Ivansquark/displinux/dtc_instruction.txt

IDE=arch/riscv/boot/dts/sun20i-d1s-nezha-linux
SRC=$IDE.dts
TMP=$IDE.tmp.dts
DST=$IDE.dtb

cpp -nostdinc -I include -undef -x assembler-with-cpp $SRC > $TMP
dtc -O dtb -b 0 -o $DST $TMP
rm $TMP
