Ivansquark/displinux/LCPI-T113_D1s_F133(303F133D1S3).pdf

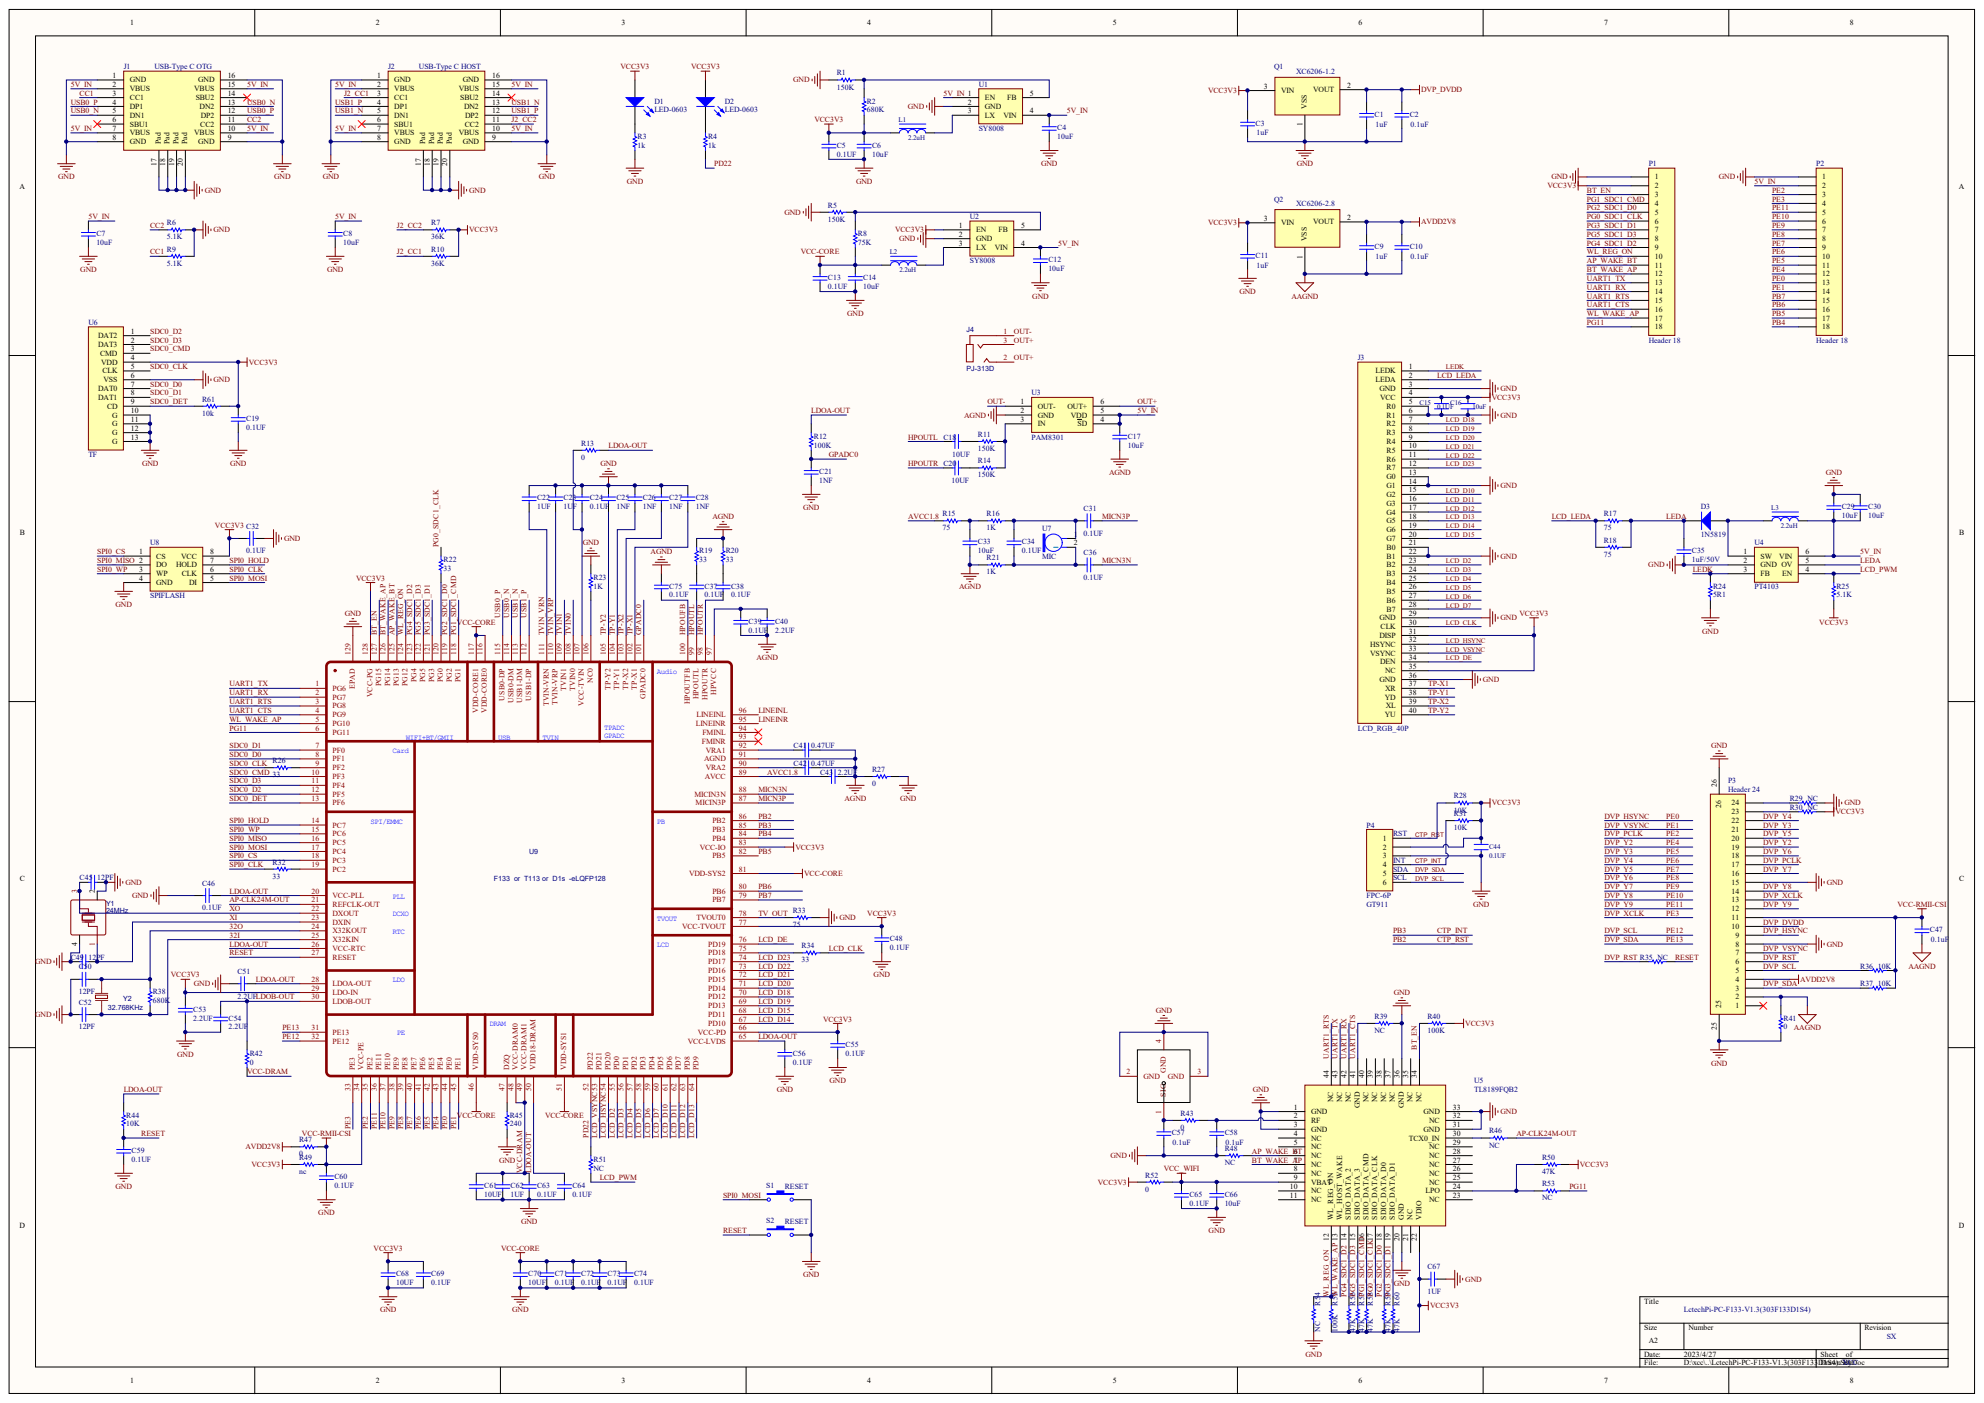
[picture p1: page 1]

INT | CTP_INT

GND | LDO-IN 29
