Ivansquark/displinux/displinux/displinux.kicad_pcb

## KiCad design displinux/displinux.kicad_pcb (2024-12-24)

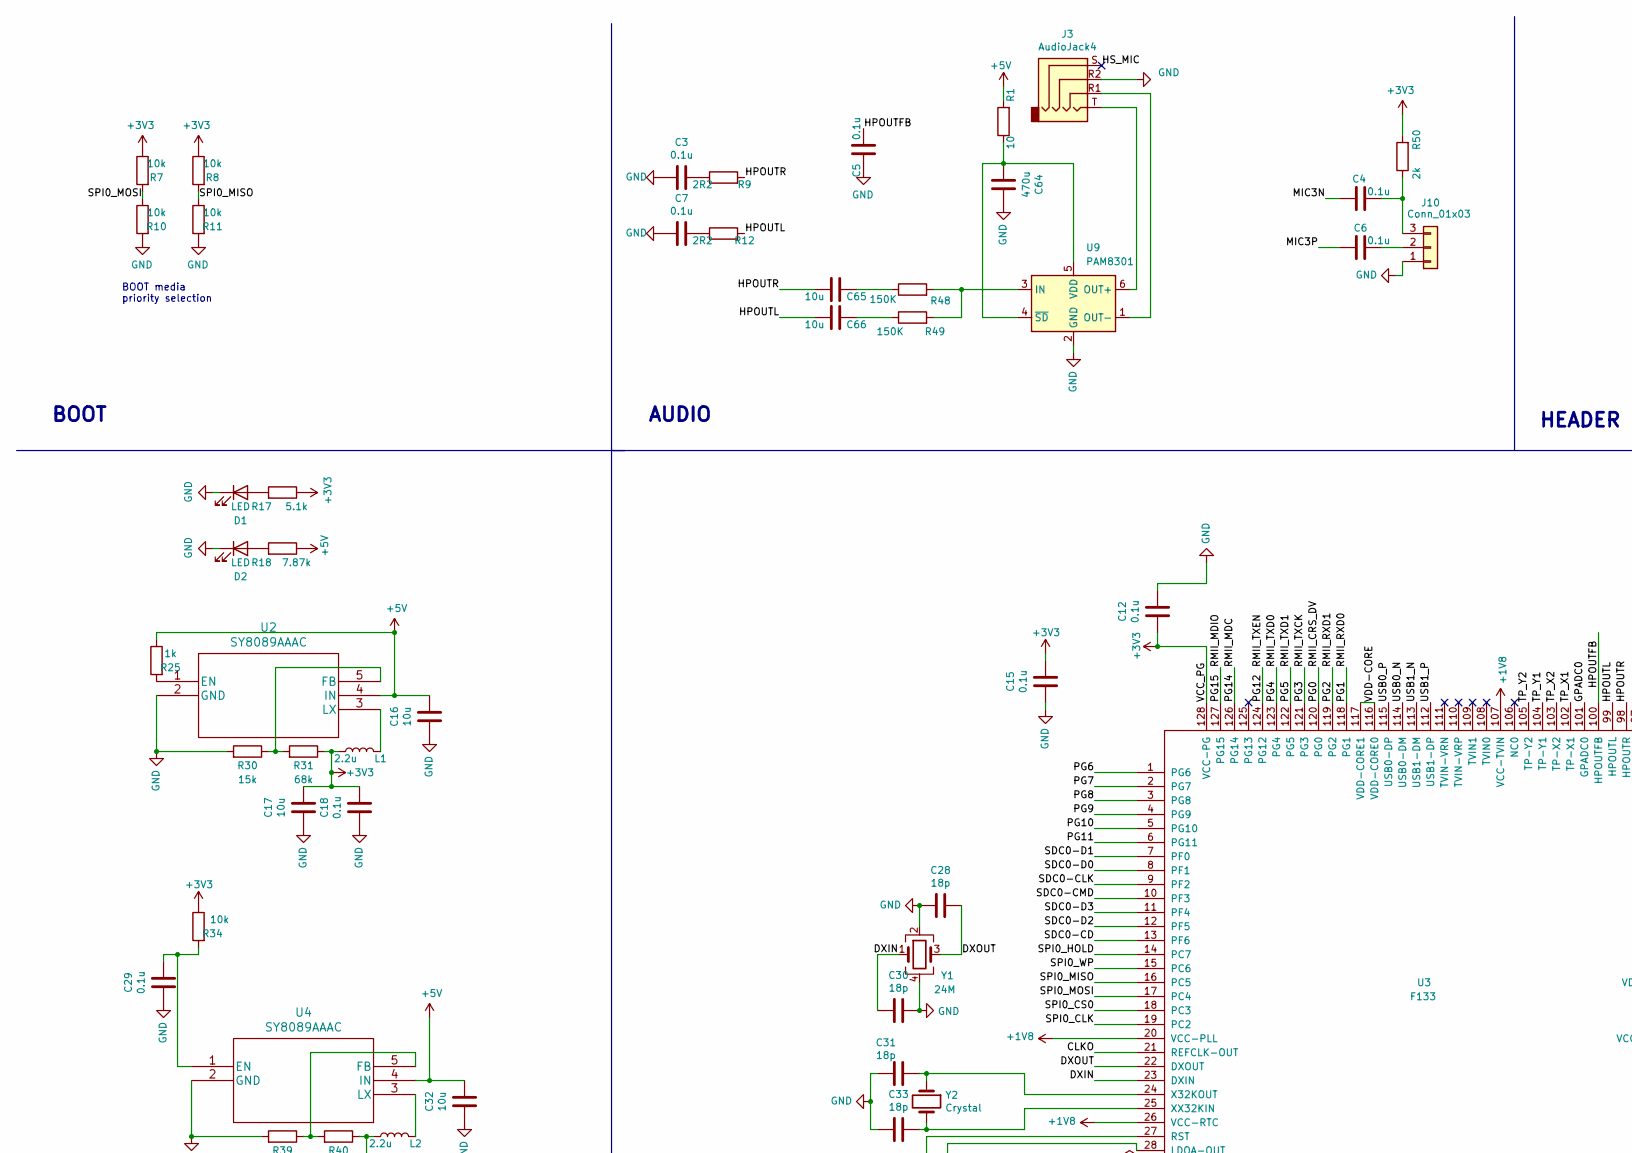
[picture p2: schematic displinux.kicad_sch, part in row 1, column 1]

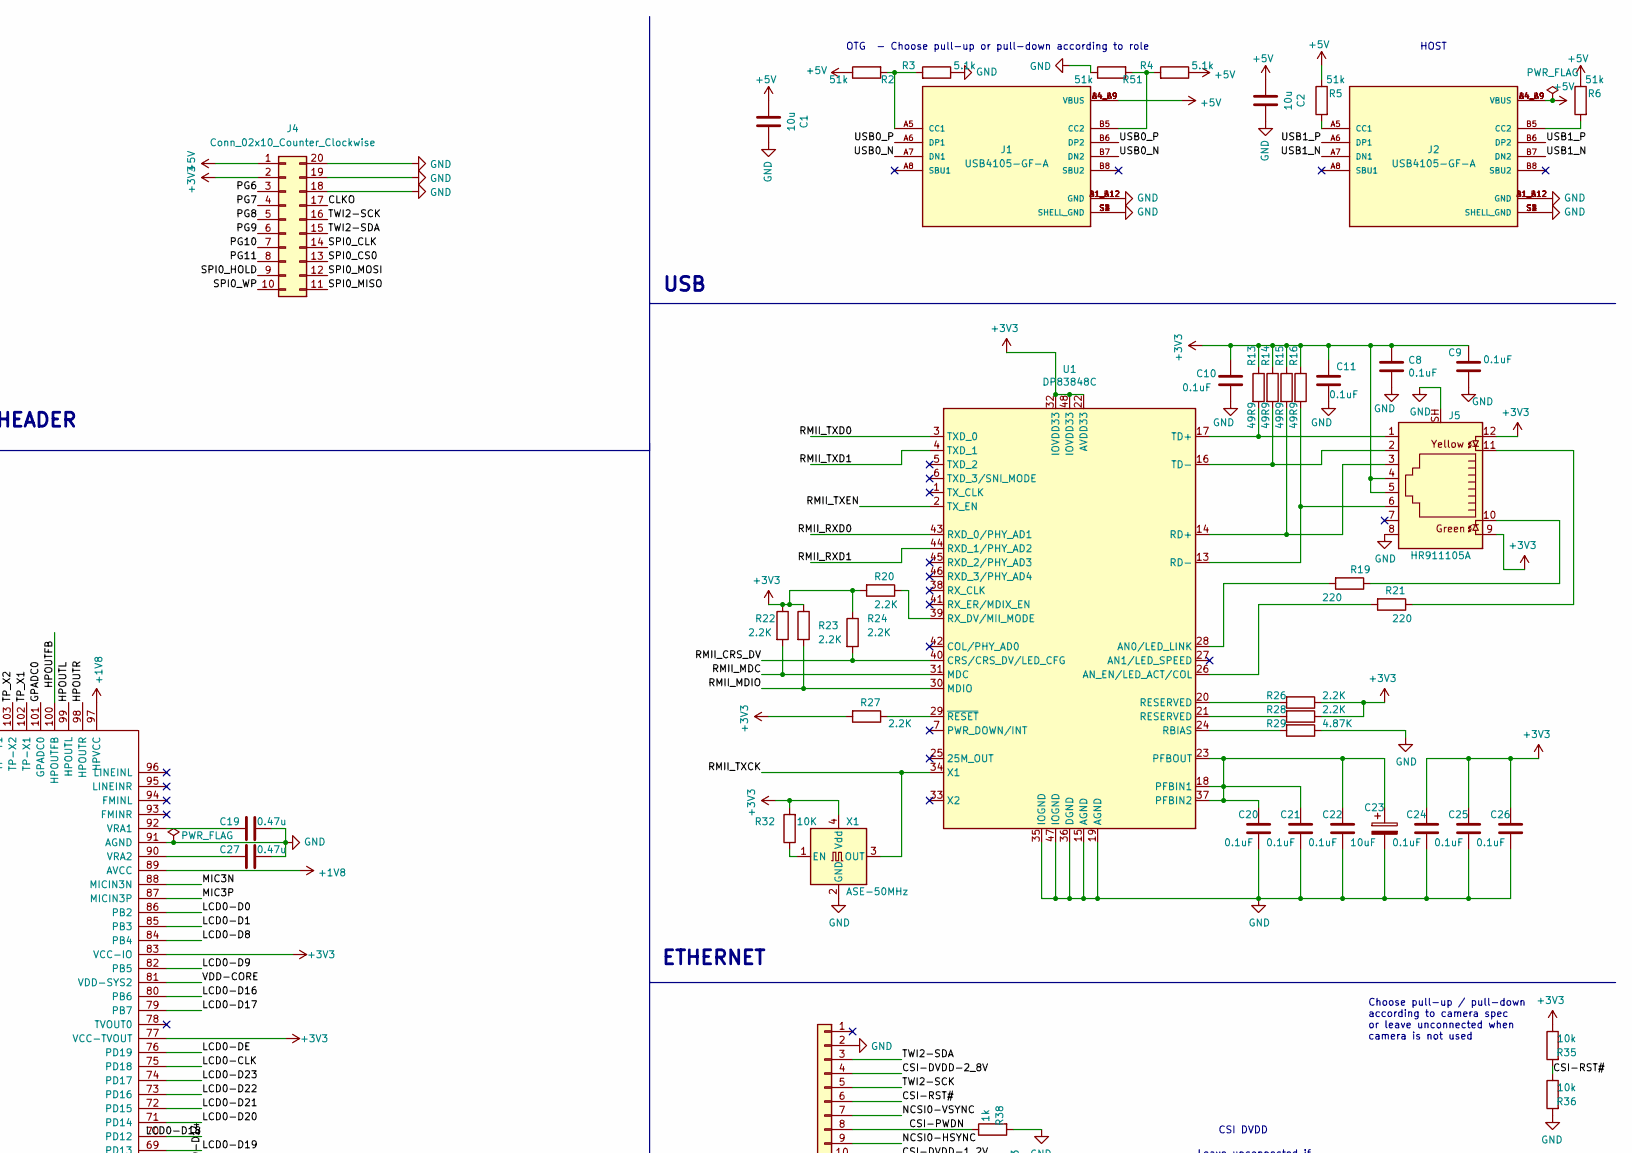
[picture p3: schematic displinux.kicad_sch, part in row 1, column 2]

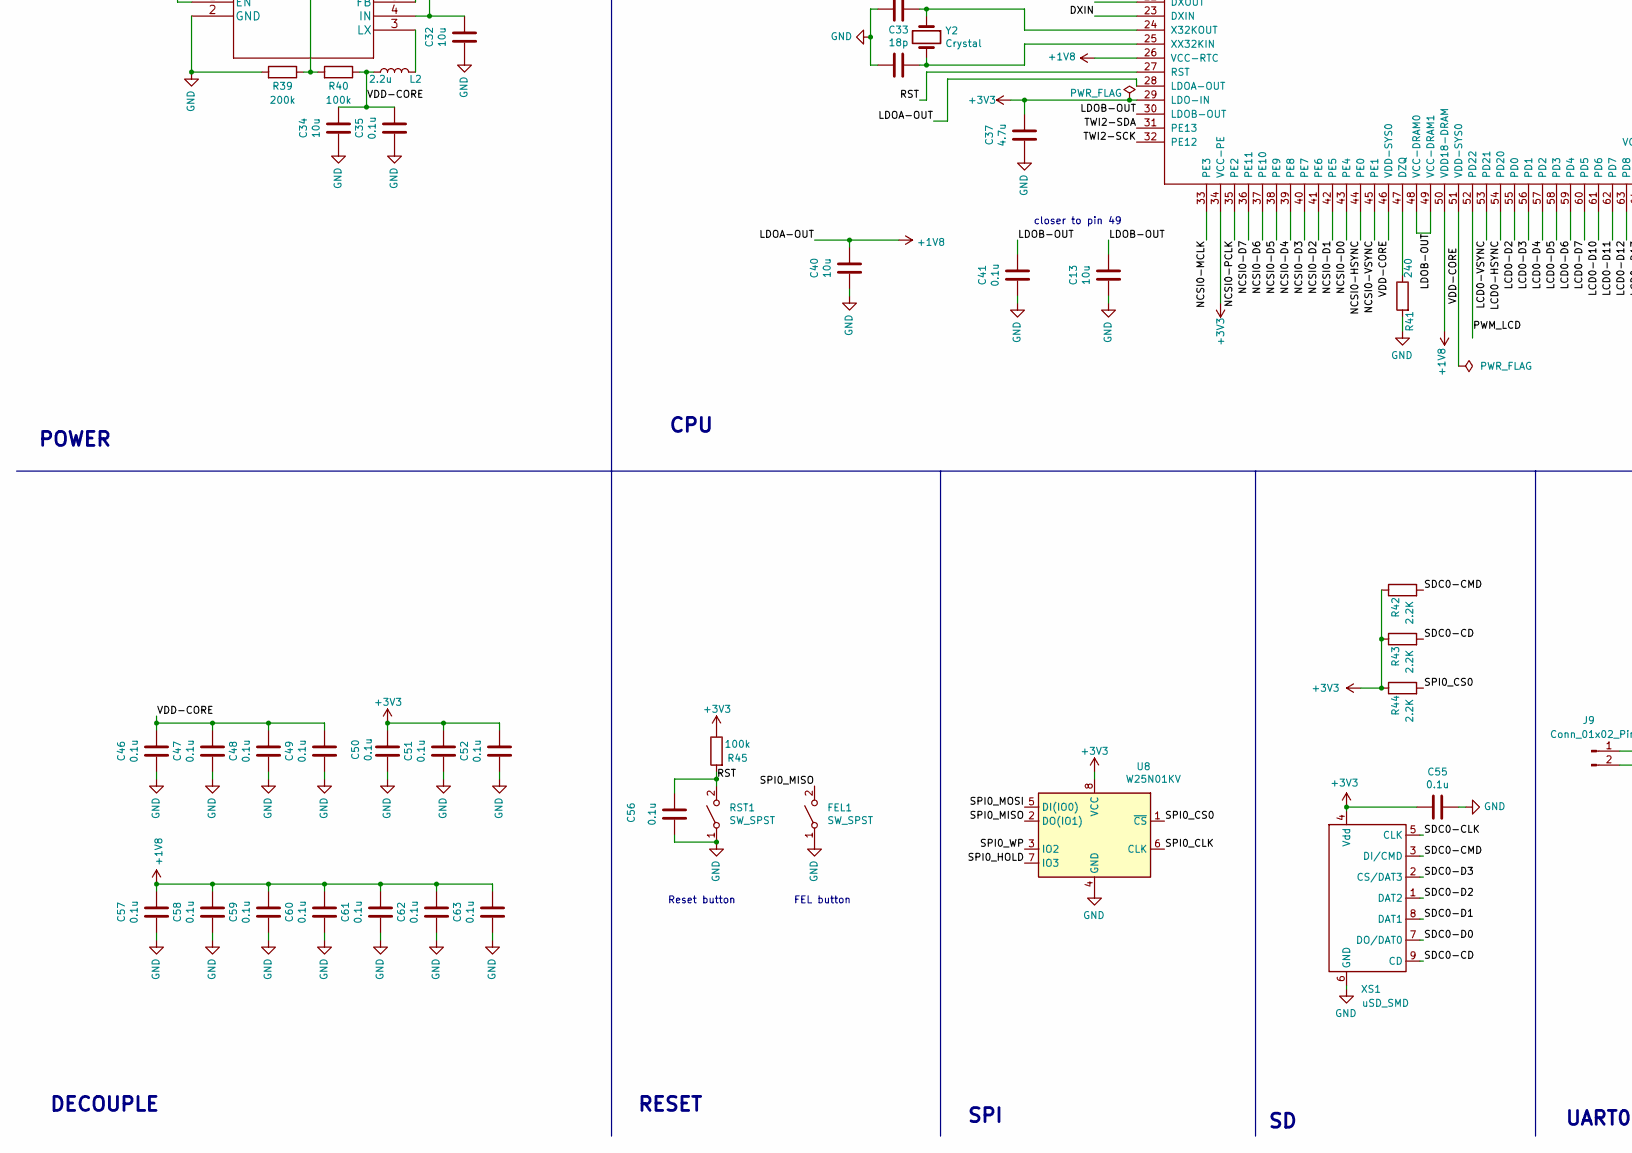
[picture p4: schematic displinux.kicad_sch, part in row 2, column 1]

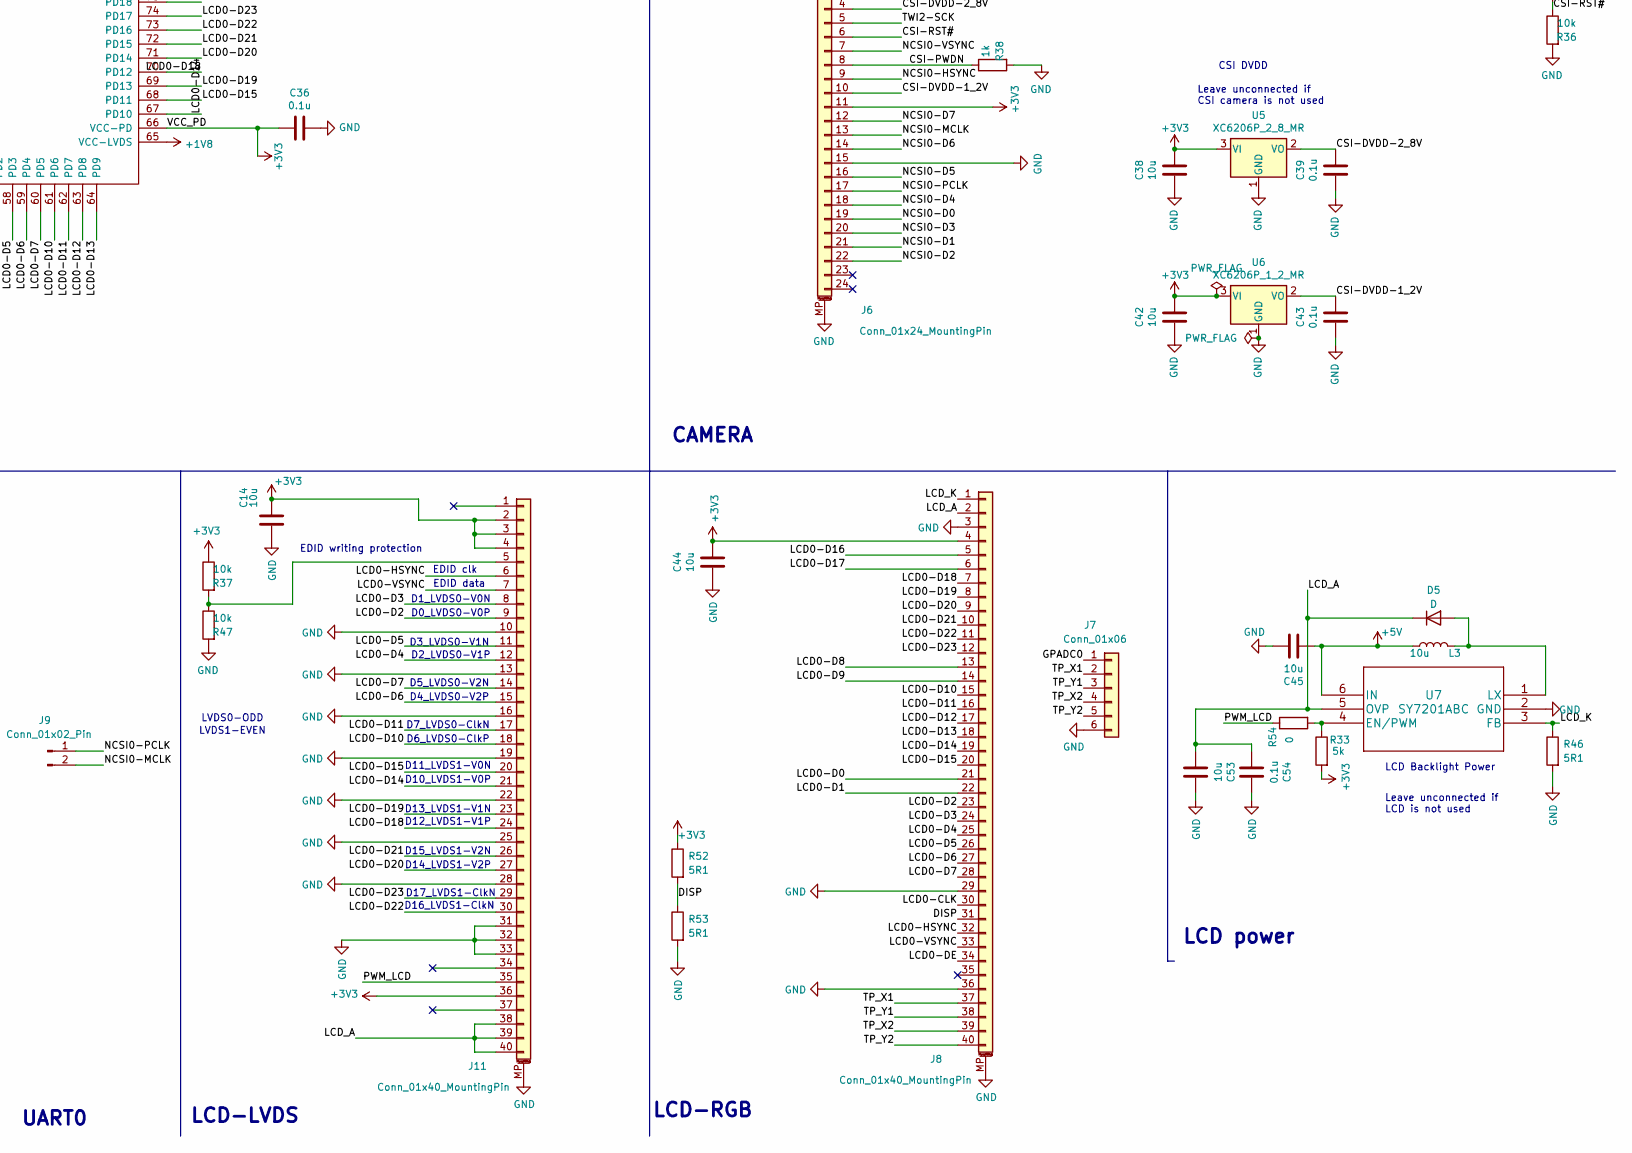
[picture p5: schematic displinux.kicad_sch, part in row 2, column 2]

Parts:
C1, C2, C13, C14, C16, C17, C32, C34, C38, C40, C42, C44, C45, C53, C65, C66: 10u; C_0603_1608Metric
C3, C4, C5, C6, C7, C12, C15, C18, C29, C35, C36, C39, C41, C43, C46, C47, C48, C49, C50, C51, C52, C54, C55, C56, C57, C58, C59, C60, C61, C62, C63: 0.1u; C_0603_1608Metric
C8, C9, C10, C11, C20, C21, C22, C24, C25, C26: 0.1uF; C_0603_1608Metric
C19, C27: 0.47u; C_0603_1608Metric
C23: 10uF; CP_EIA-3216-10_Kemet-I
C28, C30, C31, C33: 18p; C_0603_1608Metric
C37: 4.7u; C_0603_1608Metric
C64: 470u; C_0603_1608Metric
D1, D2: LED; LED_0603_1608Metric
D5: D; D_2010_5025Metric
FEL1: SW_SPST; SW_SPST_EVQPE1
J1, J2: USB4105-GF-A; USB_C_Receptacle_G-Switch_GT-USB-7010ASV; PARTREV A3
J3: AudioJack4; Jack_3.5mm_PJ320D_Horizontal
J4: Conn_02x10_Counter_Clockwise; PinHeader_2x10_P2.54mm_Vertical
J5: HR911105A; RJ45_Hanrun_HR911105A_Horizontal
J6: Conn_01x24_MountingPin; TE_2-1734839-4_1x24-1MP_P0.5mm_Horizontal
J7: Conn_01x06; PinHeader_1x06_P2.54mm_Vertical
J8, J11: Conn_01x40_MountingPin; TE_4-1734839-0_1x40-1MP_P0.5mm_Horizontal
J9: Conn_01x02_Pin; PinHeader_1x02_P2.54mm_Vertical
J10: Conn_01x03; PinHeader_1x03_P2.54mm_Vertical
L1, L2: 2.2u; L_Wurth_WE-LQSH-3012
L3: 10u; L_Wurth_WE-LQSH-3012
R1: 10; R_0603_1608Metric
R2, R5, R6, R51: 51k; R_0603_1608Metric
R3, R4, R17: 5.1k; R_0603_1608Metric
R7, R8, R10, R11, R34, R35, R36, R37, R47: 10k; R_0603_1608Metric
R9, R12: 2R2; R_0603_1608Metric
R13, R14, R15, R16: 49R9; R_0603_1608Metric
R18: 7.87k; R_0603_1608Metric
R19, R21: 220; R_0603_1608Metric
R20, R22, R23, R24, R26, R27, R28, R42, R43, R44: 2.2K; R_0603_1608Metric
R25, R38: 1k; R_0603_1608Metric
R29: 4.87K; R_0805_2012Metric_Pad1.20x1.40mm_HandSolder
R30: 15k; R_0603_1608Metric
R31: 68k; R_0603_1608Metric
R32: 10K; R_0603_1608Metric
R33: 5k; R_0603_1608Metric
R39: 200k; R_0603_1608Metric
R40, R45: 100k; R_0603_1608Metric
R41: 240; R_0603_1608Metric
R46, R52, R53: 5R1; R_0603_1608Metric
R48, R49: 150K; R_0603_1608Metric
R50: 2k; R_0603_1608Metric
R54: 0; R_0603_1608Metric
RST1: SW_SPST; SW_SPST_EVQPE1
U1: DP83848C; LQFP-48_7x7mm_P0.5mm
U2, U4: SY8089AAAC; SOT-23-5
U3: F133; LQFP-128_14x14mm_P0.4mm
U5: XC6206P_2_8_MR; SOT-23
U6: XC6206P_1_2_MR; SOT-23
U7: SY7201ABC; SOT-23-6
U8: W25N01KV; WSON-8-1EP_6x5mm_P1.27mm_EP3.4x4.3mm
U9: PAM8301; SOT-23-6
X1: ASE-50MHz; Oscillator_SMD_Abracon_ASE-4Pin_3.2x2.5mm
XS1: uSD_SMD; J_SD_Card-micro_socket_A
Y1: 24M; Crystal_SMD_3225-4Pin_3.2x2.5mm
Y2: Crystal; Crystal_SMD_3215-2Pin_3.2x1.5mm

Connections:
+1V8: C40.1, C57.1, C58.1, C59.1, C60.1, C61.1, C62.1, C63.1, U3.20 (VCC-PLL), U3.26 (VCC-RTC), U3.28 (LDOA-OUT), U3.50 (VDD18-DRAM), U3.65 (VCC-LVDS), U3.89 (AVCC), U3.97 (HPVCC), U3.107 (VCC-TVIN)
+3V3: C8.1, C9.1, C10.1, C11.1, C12.2, C14.1, C15.1, C17.1, C18.1, C24.1, C25.1, C26.1, C36.2, C37.1, C38.2, C42.2, C44.1, C50.1, C51.1, C52.1, C55.1, J4.2, J5.4, J5.5, J5.9, J5.12, J6.11, J8.4, J11.2, J11.3, J11.4, J11.36, L1.1, R7.1, R8.1, R13.1, R14.1, R15.1, R16.1, R17.1, R20.2, R22.1, R23.1, R24.1, R26.1, R27.2, R28.1, R31.1, R32.2, R33.2, R34.1, R35.1, R37.1, R42.1, R43.1, R44.1, R45.1, R50.2, R52.1, U1.22 (AVDD33), U1.32 (IOVDD33), U1.48 (IOVDD33), U3.29 (LDO-IN), U3.34 (VCC-PE), U3.66 (VCC-PD), U3.77 (VCC-TVOUT), U3.83 (VCC-IO), U3.128 (VCC-PG), U5.3 (VI), U6.3 (VI), U8.8 (VCC), X1.4 (Vdd), XS1.4 (Vdd)
+5V: C1.1, C2.1, C16.1, C32.1, C45.1, J1.A4_B9 (VBUS), J1.B4_A9 (VBUS), J2.A4_B9 (VBUS), J2.B4_A9 (VBUS), J4.1, L3.1, R1.2, R2.1, R4.1, R5.1, R6.1, R18.1, R25.1, U2.4 (IN), U4.4 (IN), U7.6 (IN)
/CLKO: J4.17, U3.21 (REFCLK-OUT)
/CSI-DVDD-1_2V: C43.1, J6.10, U6.2 (VO)
/CSI-DVDD-2_8V: C39.1, J6.4, U5.2 (VO)
/CSI-PWDN: J6.8, R38.1
/CSI-RST#: J6.6, R35.2, R36.1
/DISP: J8.31, R52.2, R53.1
/DXIN: C30.2, U3.23 (DXIN), Y1.1
/DXOUT: C28.1, U3.22 (DXOUT), Y1.3
/GPADC0: J7.1, U3.101 (GPADC0)
/HPOUTFB: C5.1, U3.100 (HPOUTFB)
/HPOUTL: C66.1, R12.2, U3.99 (HPOUTL)
/HPOUTR: C65.1, R9.2, U3.98 (HPOUTR)
/HS_MIC: J3.S
/LCD0-CLK: J8.30, U3.75 (PD18)
/LCD0-D0: J8.21, U3.86 (PB2)
/LCD0-D1: J8.22, U3.85 (PB3)
/LCD0-D2: J8.23, J11.9, U3.55 (PD0)
/LCD0-D3: J8.24, J11.8, U3.56 (PD1)
/LCD0-D4: J8.25, J11.12, U3.57 (PD2)
/LCD0-D5: J8.26, J11.11, U3.58 (PD3)
/LCD0-D6: J8.27, J11.15, U3.59 (PD4)
/LCD0-D7: J8.28, J11.14, U3.60 (PD5)
/LCD0-D8: J8.13, U3.84 (PB4)
/LCD0-D9: J8.14, U3.82 (PB5)
/LCD0-D10: J8.15, J11.18, U3.61 (PD6)
/LCD0-D11: J8.16, J11.17, U3.62 (PD7)
/LCD0-D12: J8.17, U3.63 (PD8)
/LCD0-D13: J8.18, U3.64 (PD9)
/LCD0-D14: J8.19, J11.21, U3.67 (PD10)
/LCD0-D15: J8.20, J11.20, U3.68 (PD11)
/LCD0-D16: J8.5, U3.80 (PB6)
/LCD0-D17: J8.6, U3.79 (PB7)
/LCD0-D18: J8.7, J11.24, U3.70 (PD12)
/LCD0-D19: J8.8, J11.23, U3.69 (PD13)
/LCD0-D20: J8.9, J11.27, U3.71 (PD14)
/LCD0-D21: J8.10, J11.26, U3.72 (PD15)
/LCD0-D22: J8.11, J11.30, U3.73 (PD16)
/LCD0-D23: J8.12, J11.29, U3.74 (PD17)
/LCD0-DE: J8.34, U3.76 (PD19)
/LCD0-HSYNC: J8.32, J11.6, U3.54 (PD20)
/LCD0-VSYNC: J8.33, J11.7, U3.53 (PD21)
/LCD_A: C53.1, C54.1, D5.1 (K), J8.2, J11.38, J11.39, J11.40, U7.5 (OVP)
/LCD_K: J8.1, R46.1, U7.3 (FB)
/LDOB-OUT: C13.1, C41.1, U3.30 (LDOB-OUT), U3.48 (VCC-DRAM0), U3.49 (VCC-DRAM1)
/MIC3N: C4.1, U3.88 (MICIN3N)
/MIC3P: C6.1, U3.87 (MICIN3P)
/NCSI0-D0: J6.19, U3.43 (PE4)
/NCSI0-D1: J6.21, U3.42 (PE5)
/NCSI0-D2: J6.22, U3.41 (PE6)
/NCSI0-D3: J6.20, U3.40 (PE7)
/NCSI0-D4: J6.18, U3.39 (PE8)
/NCSI0-D5: J6.16, U3.38 (PE9)
/NCSI0-D6: J6.14, U3.37 (PE10)
/NCSI0-D7: J6.12, U3.36 (PE11)
/NCSI0-HSYNC: J6.9, U3.44 (PE0)
/NCSI0-MCLK: J6.13, J9.2, U3.33 (PE3)
/NCSI0-PCLK: J6.17, J9.1, U3.35 (PE2)
/NCSI0-VSYNC: J6.7, U3.45 (PE1)
/PG0: R24.2, U1.40 (CRS/CRS_DV/LED_CFG), U3.120 (PG0)
/PG1: U1.43 (RXD_0/PHY_AD1), U3.118 (PG1)
/PG2: U1.44 (RXD_1/PHY_AD2), U3.119 (PG2)
/PG3: U1.34 (X1), U3.121 (PG3), X1.3 (OUT)
/PG4: U1.3 (TXD_0), U3.123 (PG4)
/PG5: U1.4 (TXD_1), U3.122 (PG5)
/PG6: J4.3, U3.1 (PG6)
/PG7: J4.4, U3.2 (PG7)
/PG8: J4.5, U3.3 (PG8)
/PG9: J4.6, U3.4 (PG9)
/PG10: J4.7, U3.5 (PG10)
/PG11: J4.8, U3.6 (PG11)
/PG12: U1.2 (TX_EN), U3.124 (PG12)
/PG14: R22.2, U1.31 (MDC), U3.126 (PG14)
/PG15: R23.2, U1.30 (MDIO), U3.127 (PG15)
/PWM_LCD: J11.35, R54.1, U3.52 (PD22)
/RST: C56.1, R45.2, RST1.2 (B), U3.27 (RST)
/SDC0-CD: R43.2, U3.13 (PF6), XS1.9 (CD)
/SDC0-CLK: U3.9 (PF2), XS1.5 (CLK)
/SDC0-CMD: R42.2, U3.10 (PF3), XS1.3 (DI/CMD)
/SDC0-D0: U3.8 (PF1), XS1.7 (DO/DAT0)
/SDC0-D1: U3.7 (PF0), XS1.8 (DAT1)
/SDC0-D2: U3.12 (PF5), XS1.1 (DAT2)
/SDC0-D3: U3.11 (PF4), XS1.2 (CS/DAT3)
/SPI0_CLK: J4.14, U3.19 (PC2), U8.6 (CLK)
/SPI0_CS0: J4.13, R44.2, U3.18 (PC3), U8.1 (~CS)
/SPI0_HOLD: J4.9, U3.14 (PC7), U8.7 (IO3)
/SPI0_MISO: FEL1.2 (B), J4.11, R8.2, R11.1, U3.16 (PC5), U8.2 (DO(IO1))
/SPI0_MOSI: J4.12, R7.2, R10.1, U3.17 (PC4), U8.5 (DI(IO0))
/SPI0_WP: J4.10, U3.15 (PC6), U8.3 (IO2)
/TP_X1: J7.2, J8.37, U3.102 (TP-X1)
/TP_X2: J7.4, J8.39, U3.103 (TP-X2)
/TP_Y1: J7.3, J8.38, U3.104 (TP-Y1)
/TP_Y2: J7.5, J8.40, U3.105 (TP-Y2)
/TWI2-SCK: J4.16, J6.5, U3.32 (PE12)
/TWI2-SDA: J4.15, J6.3, U3.31 (PE13)
/USB0_N: J1.A7 (DN1), J1.B7 (DN2), U3.114 (USB0-DM)
/USB0_P: J1.A6 (DP1), J1.B6 (DP2), U3.115 (USB0-DP)
/USB1_N: J2.A7 (DN1), J2.B7 (DN2), U3.113 (USB1-DM)
/USB1_P: J2.A6 (DP1), J2.B6 (DP2), U3.112 (USB1-DP)
/VDD-CORE: C34.1, C35.1, C46.1, C47.1, C48.1, C49.1, L2.1, R40.1, U3.46 (VDD-SYS0), U3.51 (VDD-SYS0), U3.81 (VDD-SYS2), U3.116 (VDD-CORE0), U3.117 (VDD-CORE1)
GND: C1.2, C2.2, C3.1, C5.2, C7.1, C8.2, C9.2, C10.2, C11.2, C12.1, C13.2, C14.2, C15.2, C16.2, C17.2, C18.2, C19.1, C20.2, C21.2, C22.2, C23.2, C24.2, C25.2, C26.2, C27.1, C28.2, C29.2, C30.1, C31.2, C32.2, C33.2, C34.2, C35.2, C36.1, C37.2, C38.1, C39.2, C40.2, C41.2, C42.1, C43.2, C44.2, C45.2, C46.2, C47.2, C48.2, C49.2, C50.2, C51.2, C52.2, C53.2, C54.2, C55.2, C56.2, C57.2, C58.2, C59.2, C60.2, C61.2, C62.2, C63.2, C64.2, D1.1 (K), D2.1 (K), FEL1.1 (A), J1.A1_B12 (GND), J1.B1_A12 (GND), J1.S1 (SHELL_GND), J1.S2 (SHELL_GND), J1.S3 (SHELL_GND), J1.S4 (SHELL_GND), J2.A1_B12 (GND), J2.B1_A12 (GND), J2.S1 (SHELL_GND), J2.S2 (SHELL_GND), J2.S3 (SHELL_GND), J2.S4 (SHELL_GND), J3.R2, J4.18, J4.19, J4.20, J5.8, J5.SH, J6.2, J6.15, J6.MP (MountPin), J7.6, J8.3, J8.29, J8.36, J8.MP (MountPin), J10.1, J11.10, J11.13, J11.16, J11.19, J11.22, J11.25, J11.28, J11.31, J11.32, J11.33, J11.MP (MountPin), R3.1, R10.2, R11.2, R29.1, R30.2, R36.2, R38.2, R39.2, R41.2, R46.2, R47.2, R51.1, R53.2, RST1.1 (A), U1.15 (AGND), U1.19 (AGND), U1.35 (IOGND), U1.36 (DGND), U1.47 (IOGND), U2.2 (GND), U3.91 (AGND), U4.2 (GND), U5.1 (GND), U6.1 (GND), U7.2 (GND), U8.4 (GND), U9.2 (GND), X1.2 (GND), XS1.6 (GND), XS1.SH, Y1.2, Y1.4
unnamed: C3.2, R9.1
unnamed: C7.2, R12.1
unnamed: C65.2, R48.1
unnamed: C66.2, R49.1
unnamed: D1.2 (A), R17.2
unnamed: D2.2 (A), R18.2
unnamed: D5.2 (A), L3.2, U7.1 (LX)
unnamed: J1.A5 (CC1), R2.2, R3.2
unnamed: J1.B5 (CC2), R4.2, R51.2
unnamed: J2.A5 (CC1), R5.2
unnamed: J2.B5 (CC2), R6.2
unnamed: J5.10, R19.1
unnamed: J5.11, R21.1
unnamed: C6.2, J10.2
unnamed: C4.2, J10.3, R50.1
unnamed: J11.5, R37.2, R47.1
unnamed: R26.2, U1.20 (RESERVED)
unnamed: R28.2, U1.21 (RESERVED)
unnamed: R19.2, U1.28 (AN0/LED_LINK)
unnamed: R21.2, U1.26 (AN_EN/LED_ACT/COL)
unnamed: C20.1, C21.1, C22.1, C23.1, U1.18 (PFBIN1), U1.23 (PFBOUT), U1.37 (PFBIN2)
unnamed: R29.2, U1.24 (RBIAS)
unnamed: J5.3, R15.2, U1.14 (RD+)
unnamed: J5.6, R16.2, U1.13 (RD-)
unnamed: R20.1, U1.39 (RX_DV/MII_MODE)
unnamed: J5.1, R13.2, U1.17 (TD+)
unnamed: J5.2, R14.2, U1.16 (TD-)
unnamed: R27.1, U1.29 (~RESET)
unnamed: R25.2, U2.1 (EN)
unnamed: R30.1, R31.2, U2.5 (FB)
unnamed: L1.2, U2.3 (LX)
unnamed: R41.1, U3.47 (DZQ)
unnamed: C19.2, U3.92 (VRA1)
unnamed: C27.2, U3.90 (VRA2)
unnamed: C31.1, U3.24 (X32KOUT), Y2.1
unnamed: C33.1, U3.25 (XX32KIN), Y2.2
unnamed: C29.1, R34.2, U4.1 (EN)
unnamed: R39.1, R40.2, U4.5 (FB)
unnamed: L2.2, U4.3 (LX)
unnamed: R33.1, R54.2, U7.4 (EN/PWM)
unnamed: R48.2, R49.2, U9.3 (IN)
unnamed: J3.T, U9.6 (OUT+)
unnamed: J3.R1, U9.1 (OUT-)
unnamed: C64.1, R1.1, U9.4 (~SD), U9.5 (VDD)
unnamed: R32.1, X1.1 (EN)

Notes on the sheet:
USB
BOOT
SPI
D10_LVDS1-V0P
closer to pin 49
LVDS1-EVEN
D11_LVDS1-V0N
D1_LVDS0-V0N
HOST
D4_LVDS0-V2P
CAMERA
D0_LVDS0-V0P
EDID clk
D3_LVDS0-V1N
D17_LVDS1-ClkN
D5_LVDS0-V2N
Choose pull-up / pull-down according to camera spec or leave unconnected when camera is not used
Leave unconnected if LCD is not used
D2_LVDS0-V1P
D13_LVDS1-V1N
D12_LVDS1-V1P
CSI DVDD
D15_LVDS1-V2N
D6_LVDS0-ClkP
DECOUPLE
LCD-LVDS
EDID writing protection
UART0
BOOT media priority selection
HEADER
POWER
LCD-RGB
FEL button
D16_LVDS1-ClkN
D14_LVDS1-V2P
D7_LVDS0-ClkN
OTG - Choose pull-up or pull-down according to role
EDID data
LCD power
LCD Backlight Power
CPU
RESET
ETHERNET
Reset button
LVDS0-ODD
AUDIO
Leave unconnected if CSI camera is not used

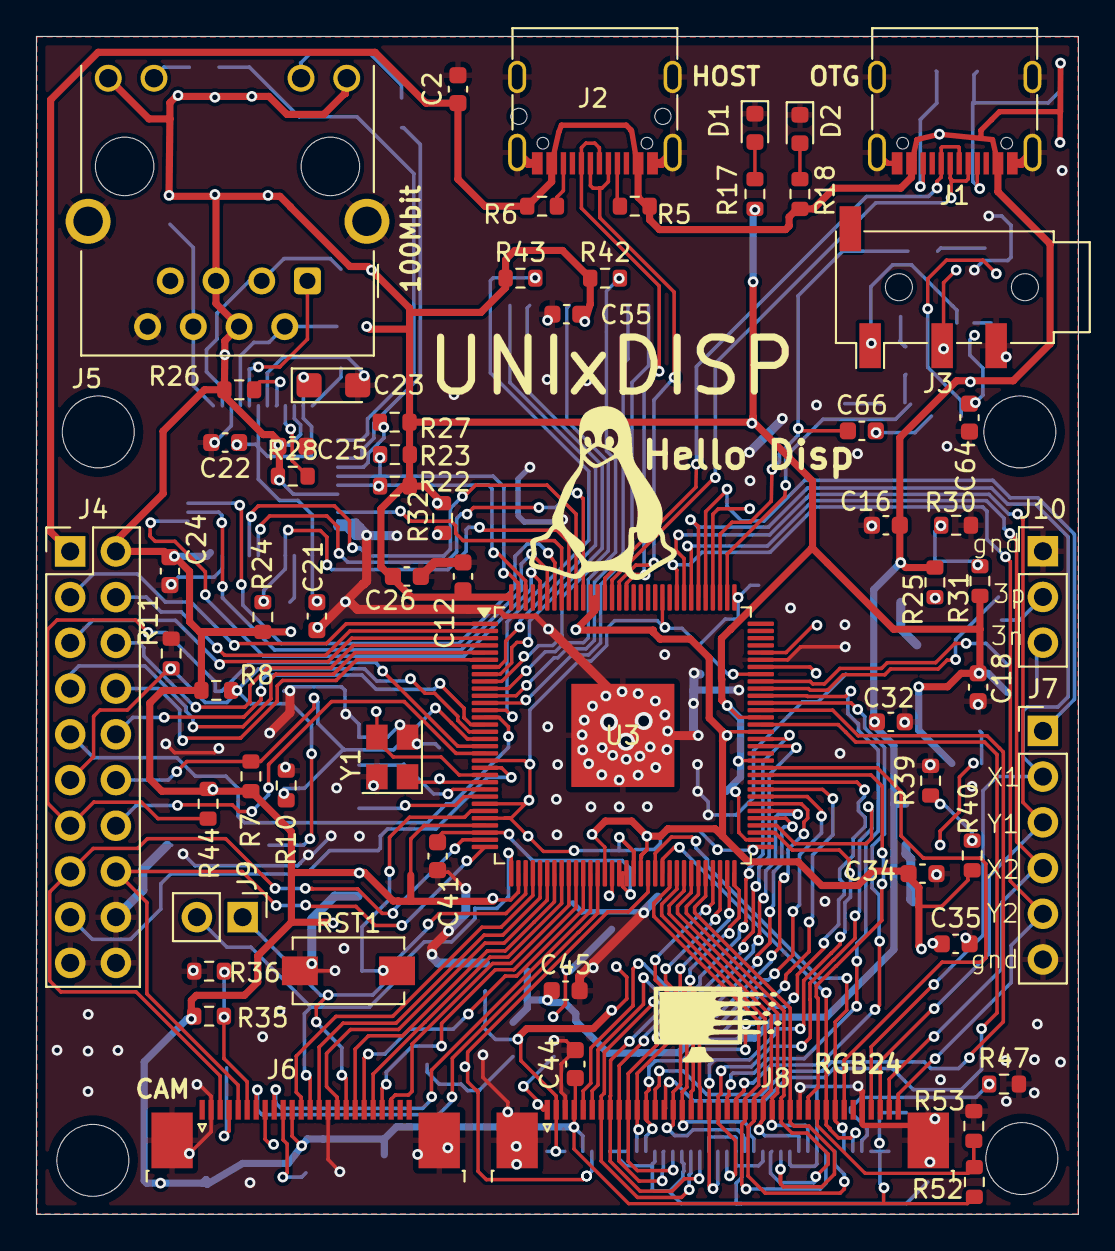
[picture p6: board displinux.kicad_pcb from above]

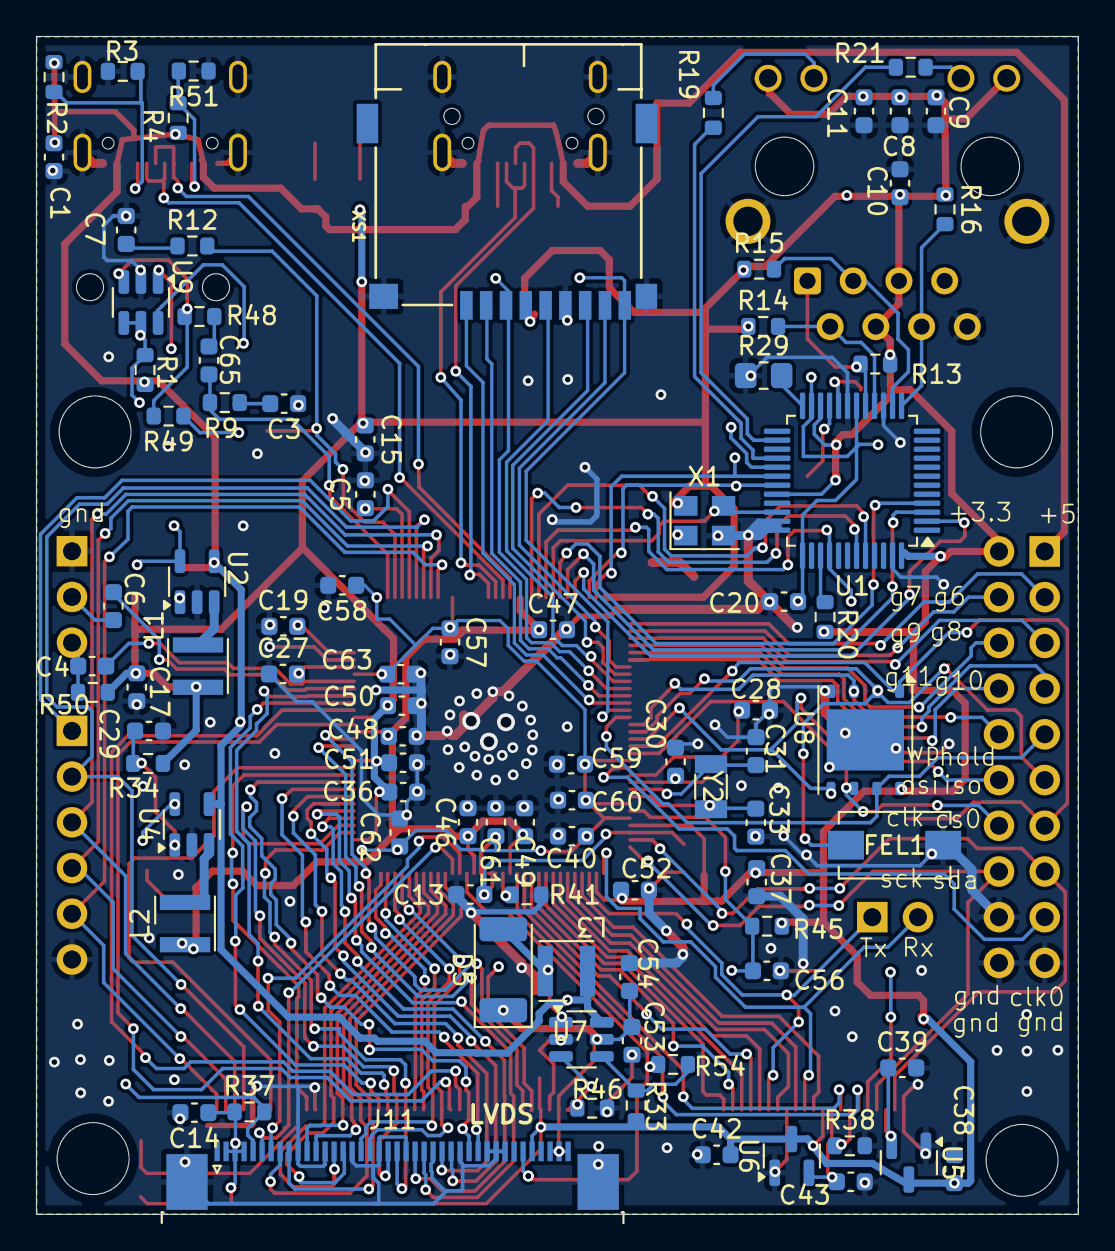
[picture p7: board displinux.kicad_pcb from below]

Board: 2 copper layers, 57.9 x 65.4 mm, 153 parts (90 on the bottom side), 147 nets.

Other parts of the board:
Hello Disp: LOGO; linux_mascot
