Ivansquark/displinux/example/Xassette-Asterisk/hw/XassetteAsterisk.kicad_pcb

## KiCad design example/Xassette-Asterisk/hw/XassetteAsterisk.kicad_pcb (2024-07-05)

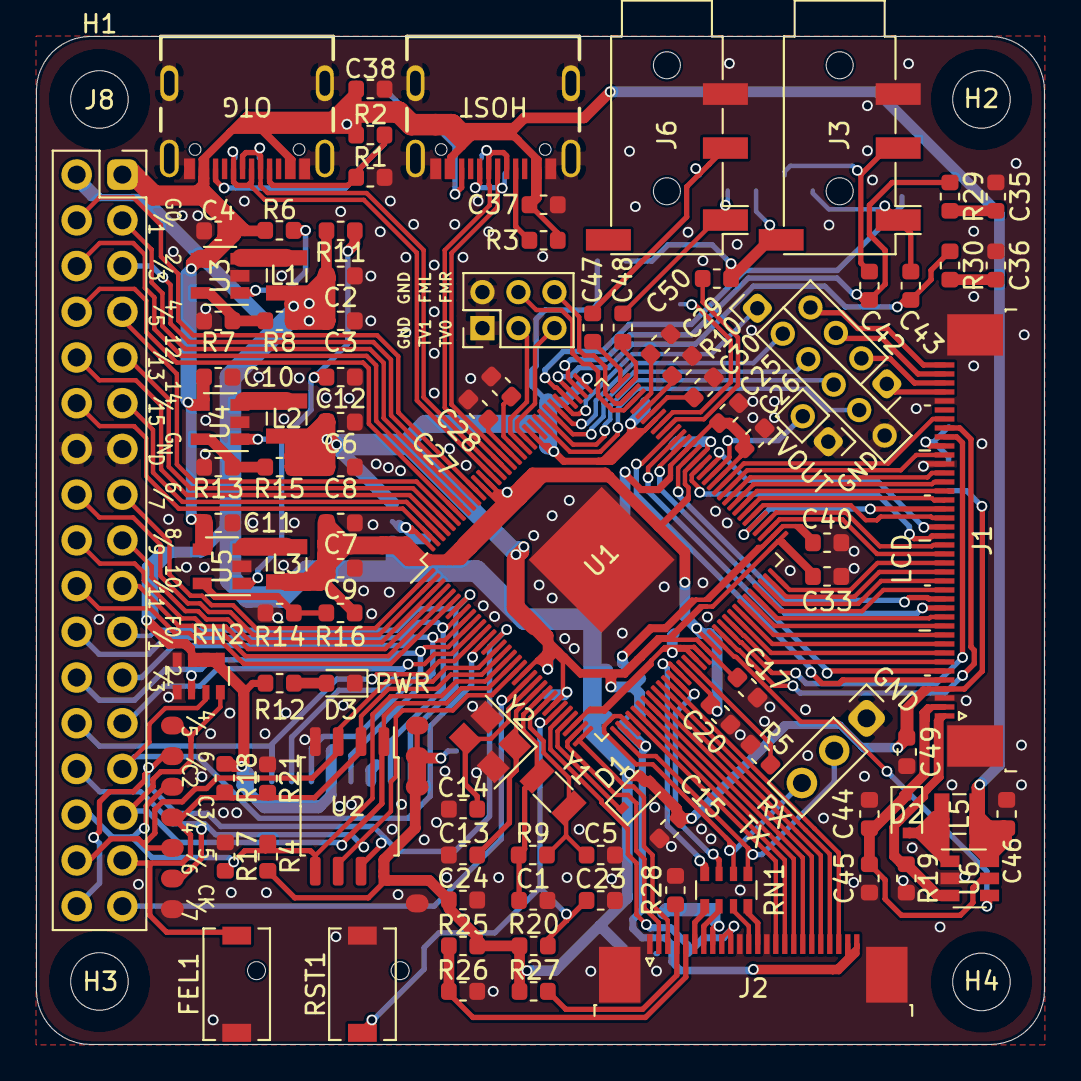
[picture p9: board XassetteAsterisk.kicad_pcb from above]

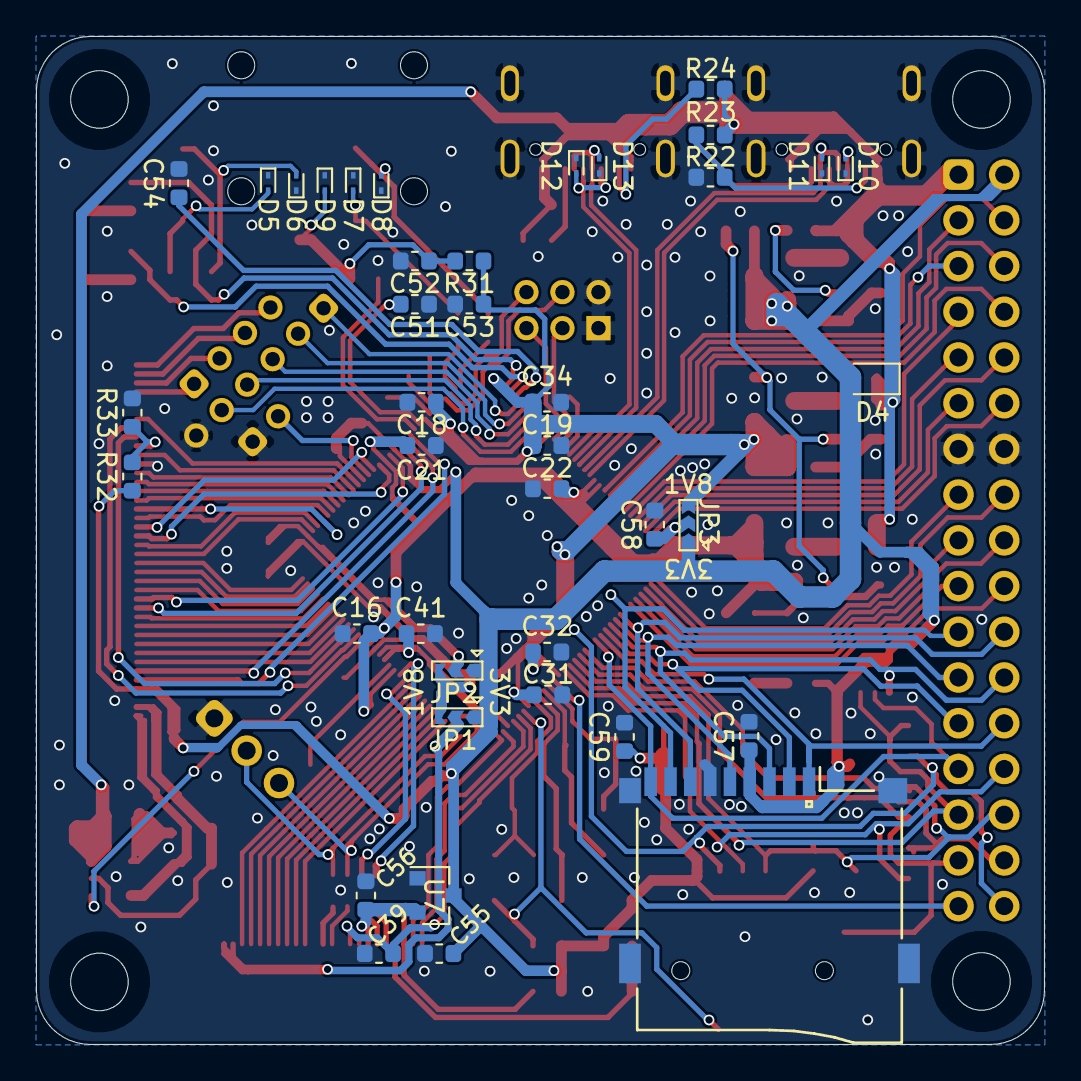
[picture p10: board XassetteAsterisk.kicad_pcb from below]

Board: 2 copper layers, 56.0 x 56.0 mm, 145 parts (41 on the bottom side), 151 nets.

Parts:
C1, C5, C13, C14: 18p; C_0603_1608Metric
C2, C4, C6, C7, C10, C11, C37, C38, C44, C46, C53, C55: 10u; C_0603_1608Metric
C3, C8, C9, C12, C15, C16, C17, C18, C19, C20, C21, C22, C23, C24, C25, C26, C31, C32, C33, C34, C35, C36, C39, C40, C41, C42, C43, C45, C47, C48, C49, C50, C51, C54, C56, C57, C58, C59: 0.1u; C_0603_1608Metric
C27, C28: 1u; C_0603_1608Metric
C29, C30: 0.47u; C_0603_1608Metric
C52: 33p; C_0603_1608Metric
D1, D2, D4: D; D_SOD-323
D3: LED; LED_0603_1608Metric
D5, D6, D7, D8, D9, D10, D11, D12, D13: ESD9B3.3ST5G; D_SOD-923
FEL1: SW_SPST; SW_SPST_EVQPE1
H1, H2, H3, H4: MountingHole; MountingHole_3.2mm_M3
H5: MountingHole_Pad; SolderWirePad_1x01_SMD_5x10mm
J1: Conn_01x40_MountingPin; TE_4-1734839-0_1x40-1MP_P0.5mm_Horizontal
J2: Conn_01x24_MountingPin; TE_2-1734839-4_1x24-1MP_P0.5mm_Horizontal
J3, J6: AudioJack4; Jack_3.5mm_PJ320D_Horizontal
J4, J5: USB4105-GF-A; GCT_USB4105-GF-A
J7: Conn_01x04; PinSocket_1x04_P2.00mm_Vertical
J8: Conn_02x17_Odd_Even; PinSocket_2x17_P2.54mm_Vertical
J9: Conn_01x06; PinHeader_1x06_P2.00mm_Vertical
J10: Conn_02x03_Odd_Even; PinHeader_2x03_P2.00mm_Vertical
J11: Conn_01x02; PinHeader_1x02_P2.00mm_Vertical
J12: Conn_01x03; PinHeader_1x03_P2.54mm_Vertical
J13: RTL8189FTV_Mod; 8189Mod
JP1, JP2, JP3: Jumper_3_Open; SolderJumper-3_P2.0mm_Open_TrianglePad1.0x1.5mm
L1, L2, L3: 2.2u; L_Wuerth_MAPI-2510
L5: 10u; L_Wuerth_MAPI-2510
R1, R2, R3, R12, R22, R23, R24: 5.1k; R_0603_1608Metric
R4, R11, R17, R18, R21, R25, R26, R27, R28, R32, R33: 10k; R_0603_1608Metric
R5: 240; R_0603_1608Metric
R6: 1k; R_0603_1608Metric
R7: 15k; R_0603_1608Metric
R8: 68k; R_0603_1608Metric
R9: 10M; R_0603_1608Metric
R10: 0; R_0603_1608Metric
R13, R16, R20: 100k; R_0603_1608Metric
R14, R15: 200k; R_0603_1608Metric
R19, R29, R30: 2R2; R_0603_1608Metric
R31: 2.2k; R_0603_1608Metric
RN1, RN2: R_Pack04; R_Array_Convex_4x0603
RST1: SW_SPST; SW_SPST_EVQPE1
Ref**: Val**; rvlogo_inv
U1: F133; LQFP-128_14x14mm_P0.4mm
U2: W25Q32JVSS; SOIC-8_5.23x5.23mm_P1.27mm
U3, U4, U5: SY8089AAAC; SOT-23-5
U6: SY7201ABC; SOT-23-6
U7: XC6206PxxxMR; SOT-23
XS1: uSD_SMD; Conn_uSDcard
Y1: Crystal; Crystal_SMD_3215-2Pin_3.2x1.5mm
Y2: 24M; Crystal_SMD_3225-4Pin_3.2x2.5mm

Connections:
+1V8: C6.1, C8.1, C17.1, C18.1, C19.1, C31.1, C32.1, C33.1, C34.1, C53.1, JP1.3, JP2.3, JP3.3, L2.1, R15.1, R31.1, U1.20, U1.26, U1.50, U1.65, U1.89, U1.97, U1.107
+3V3: C2.1, C3.1, C15.1, C24.1, C25.1, C26.1, C49.1, C55.2, C57.1, C59.1, D1.2, D4.2, J1.4, J8.2, J13.11, J13.12, J13.13, JP1.1, JP2.1, JP3.1, L1.1, R4.1, R8.1, R11.1, R12.1, R18.1, R20.1, R25.1, R27.1, R32.1, RN2.1, RN2.2, RN2.3, U1.77, U1.83, U2.8, U7.3, XS1.4
+5V: C4.1, C10.1, C11.1, C37.1, C38.1, C46.1, D4.1, J4.A4_B9, J4.B4_A9, J5.A4_B9, J5.B4_A9, J8.1, L5.1, R2.1, R3.1, R6.1, R23.1, R24.1, U3.4, U4.4, U5.4, U6.6
/CLKO: J8.33, U1.21
/CSI-AVDD: C39.1, J2.9, J2.10, U1.28
/CSI-DVDD: C56.1, J2.8, U7.2
/CSI-IOVDD: J2.23, J2.24, JP1.2, U1.34
/CSI-PWDN: J2.5, R25.2, R26.1
/CSI-RST#: J2.4, R27.2, R28.1
/DISP: J1.31, R32.2, R33.1
/DXIN: C13.2, U1.23, Y2.1
/DXOUT: C14.1, U1.22, Y2.3
/FMINL: J10.6, U1.94
/FMINR: J10.4, U1.93
/GPADC0: J9.1, U1.101
/HPOUTFB: C54.1, U1.100
/HPOUTL: C43.2, R30.2, U1.99
/HPOUTR: C42.2, R29.2, U1.98
/HS_MIC: C50.2, C52.1, D9.2, J3.S, R31.2
/LCD0-CLK: J1.30, U1.75
/LCD0-D0: J1.5, U1.86
/LCD0-D1: J1.6, U1.85
/LCD0-D2: J1.7, U1.55
/LCD0-D3: J1.8, U1.56
/LCD0-D4: J1.9, U1.57
/LCD0-D5: J1.10, U1.58
/LCD0-D6: J1.11, U1.59
/LCD0-D7: J1.12, U1.60
/LCD0-D8: J1.13, U1.84
/LCD0-D9: J1.14, U1.82
/LCD0-D10: J1.15, U1.61
/LCD0-D11: J1.16, U1.62
/LCD0-D12: J1.17, U1.63
/LCD0-D13: J1.18, U1.64
/LCD0-D14: J1.19, U1.67
/LCD0-D15: J1.20, U1.68
/LCD0-D16: J1.21, U1.80
/LCD0-D17: J1.22, U1.79
/LCD0-D18: J1.23, U1.70
/LCD0-D19: J1.24, U1.69
/LCD0-D20: J1.25, U1.71
/LCD0-D21: J1.26, U1.72
/LCD0-D22: J1.27, U1.73
/LCD0-D23: J1.28, U1.74
/LCD0-DE: J1.34, U1.76
/LCD0-HSYNC: J1.32, U1.54
/LCD0-VSYNC: J1.33, U1.53
/LCD0_PWM: U1.52, U6.4
/LCD_A: C44.1, C45.1, D2.1, J1.2, U6.5
/LCD_K: J1.1, R19.1, U6.3
/LDOB-OUT: C41.1, U1.30, U1.48, U1.49
/LINEL: C47.2, U1.96
/LINER: C48.2, U1.95
/MIC3N: C51.1, U1.88
/MIC3P: C50.1, U1.87
/NCSI0-D0: J2.22, U1.43
/NCSI0-D1: J2.21, U1.42
/NCSI0-D2: J2.20, U1.41
/NCSI0-D3: J2.19, U1.40
/NCSI0-D4: J2.18, U1.39
/NCSI0-D5: J2.17, U1.38
/NCSI0-D6: J2.16, U1.37
/NCSI0-D7: J2.15, U1.36
/NCSI0-HSYNC: RN1.7, U1.44
/NCSI0-MCLK: J12.2, RN1.5, U1.33
/NCSI0-PCLK: J12.3, RN1.6, U1.35
/NCSI0-VSYNC: RN1.8, U1.45
/PC2: J8.28, J13.6, U1.19, U2.6
/PC3: J8.29, J13.1, RN2.8, U1.18, U2.1
/PC4: J8.30, J13.3, R4.2, R17.1, U1.17, U2.5
/PC5: FEL1.2, J8.31, J13.4, R18.2, R21.1, U1.16, U2.2
/PC6: J8.32, J13.5, U1.15, U2.3
/PC7: J8.34, J13.2, U1.14, U2.7
/PF0: J8.21, U1.7, XS1.8
/PF1: J8.22, U1.8, XS1.7
/PF2: J8.23, U1.9, XS1.5
/PF3: J8.24, RN2.6, U1.10, XS1.3
/PF4: J8.25, U1.11, XS1.2
/PF5: J8.26, U1.12, XS1.1
/PF6: J8.27, RN2.7, U1.13, XS1.9
/PG0: J8.3, U1.120
/PG1: J8.4, U1.118
/PG2: J8.5, U1.119
/PG3: J8.6, U1.121
/PG4: J8.7, U1.123
/PG5: J8.8, U1.122
/PG6: J8.15, U1.1
/PG7: J8.16, U1.2
/PG8: J8.17, U1.3
/PG9: J8.18, U1.4
/PG10: J8.19, U1.5
/PG11: J8.20, U1.6
/PG12: J8.9, U1.124
/PG13: J8.10, U1.125
/PG14: J8.11, U1.126
/PG15: J8.12, U1.127
/RST: C23.1, R20.2, RST1.2, U1.27
/TP_X1: J9.2, U1.102
/TP_X2: J9.3, U1.103
/TP_Y1: J9.4, U1.104
/TP_Y2: J9.5, U1.105
/TVIN0: J10.5, U1.108
/TVIN1: J10.3, U1.109
/TVOUT: J11.2, U1.78
/TWI2-SCK: J2.3, U1.32
/TWI2-SDA: J2.2, U1.31
/USB0_N: D11.2, J4.A7, J4.B7, U1.114
/USB0_P: D10.2, J4.A6, J4.B6, U1.115
/USB1_N: D13.2, J5.A7, J5.B7, U1.113
/USB1_P: D12.2, J5.A6, J5.B6, U1.112
/VCC_PD: C40.2, JP2.2, U1.66
/VCC_PG: C58.2, JP3.2, U1.128
/VDD-CORE: C7.1, C9.1, C16.1, C20.1, C21.1, C22.1, L3.1, R16.1, U1.46, U1.51, U1.81, U1.116, U1.117
GND: C1.2, C2.2, C3.2, C4.2, C5.2, C6.2, C7.2, C8.2, C9.2, C10.2, C11.2, C12.2, C13.1, C14.2, C15.2, C16.2, C17.2, C18.2, C19.2, C20.2, C21.2, C22.2, C23.2, C24.2, C25.2, C26.2, C27.2, C28.2, C29.1, C30.1, C31.2, C32.2, C33.2, C34.2, C35.1, C36.1, C37.2, C38.2, C39.2, C40.1, C41.2, C44.2, C45.2, C46.2, C49.2, C51.2, C52.2, C53.2, C54.2, C55.1, C56.2, C57.2, C58.1, C59.2, D3.1, D5.1, D6.1, D7.1, D8.1, D9.1, D10.1, D11.1, D12.1, D13.1, FEL1.1, H5.1, J1.3, J1.29, J1.36, J1.MP, J2.1, J2.11, J2.14, J2.MP, J3.R2, J4.A1_B12, J4.B1_A12, J4.S1, J4.S2, J4.S3, J4.S4, J5.A1_B12, J5.B1_A12, J5.S1, J5.S2, J5.S3, J5.S4, J6.R2, J8.13, J8.14, J9.6, J10.1, J10.2, J11.1, J12.1, J13.7, J13.8, R1.2, R5.2, R7.2, R10.1, R13.2, R14.2, R17.2, R19.2, R21.2, R22.2, R26.2, R28.2, R33.2, RN2.4, RN2.5, RST1.1, U2.4, U3.2, U4.2, U5.2, U6.2, U7.1, XS1.6, Y2.2, Y2.4
unnamed: C1.1, R9.1, U1.24, Y1.1
unnamed: C5.1, R9.2, U1.25, Y1.2
unnamed: C12.1, R11.2, U4.1, U5.1
unnamed: C27.1, U1.111
unnamed: C28.1, U1.110
unnamed: C29.2, U1.92
unnamed: C30.2, U1.90
unnamed: C35.2, R29.1
unnamed: C36.2, R30.1
unnamed: C42.1, D6.2, J3.R1
unnamed: C43.1, D5.2, J3.T
unnamed: C47.1, D8.2, J6.R1
unnamed: C48.1, D7.2, J6.T
unnamed: D1.1, U1.29
unnamed: D2.2, L5.2, U6.1
unnamed: D3.2, R12.2
unnamed: J1.37, J7.1
unnamed: J1.38, J7.2
unnamed: J1.39, J7.3
unnamed: J1.40, J7.4
unnamed: J2.6, RN1.1
unnamed: J2.7, RN1.2
unnamed: J2.12, RN1.3
unnamed: J2.13, RN1.4
unnamed: J4.A5, R1.1, R2.2
unnamed: J4.B5, R22.1, R23.2
unnamed: J5.A5, R3.2
unnamed: J5.B5, R24.2
unnamed: L1.2, U3.3
unnamed: L2.2, U4.3
unnamed: L3.2, U5.3
unnamed: R5.1, U1.47
unnamed: R6.2, U3.1
unnamed: R7.1, R8.2, U3.5
unnamed: R10.2, U1.91
unnamed: R13.1, R15.2, U4.5
unnamed: R14.1, R16.2, U5.5
