Ivansquark/displinux/(commit log)

2024-07-05 add reference schematic and datasheet
    [BOM.csv, Brk40p.kicad_pcb, Brk40p.sch, XassetteAsterisk.kicad_pcb, XassetteAsterisk.sch, displinux.kicad_pcb, displinux.kicad_sch]
2024-07-08 add schematic
    [displinux.kicad_pcb, displinux.kicad_sch]
2024-07-12 start tracing
    [displinux.kicad_pcb, displinux.kicad_sch]
2024-07-15 tracing finished Need to check
    [displinux.kicad_pcb, displinux.kicad_sch]
2024-07-15 add some earth
    [displinux.kicad_pcb]
2024-08-02 add fabric files
    [bom.csv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]
2024-08-13 add fixes
    [displinux.kicad_pcb, displinux.kicad_sch]
2024-08-14 fix display power
    [displinux.kicad_pcb, displinux.kicad_sch]
2024-08-22 add lvds
    [displinux-B_Cu.gbr, displinux-B_Mask.gbr, displinux-B_Paste.gbr, displinux-B_Silkscreen.gbr, displinux-Edge_Cuts.gbr, displinux-F_Cu.gbr, displinux-F_Mask.gbr, displinux-F_Paste.gbr]
2024-08-29 some fixes
    [displinux.kicad_pcb, displinux.kicad_sch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]
2024-10-01 fix audio
    [displinux-B_Cu.gbr, displinux-B_Mask.gbr, displinux-B_Paste.gbr, displinux-B_Silkscreen.gbr, displinux-Edge_Cuts.gbr, displinux-F_Cu.gbr, displinux-F_Mask.gbr, displinux-F_Paste.gbr]
2024-11-26 change otg CCM1 CCM2 res
    [displinux.kicad_sch]
2024-12-24 add GND SD
    [displinux.kicad_pcb]
